miami6/The_Wifydra-2023/(notices)

Notices in the files:
README.md:
MIT License
